JaphD/Phasetag/Bluetooth_Channel_Sounding_Tag.kicad_pcb

## KiCad design Bluetooth_Channel_Sounding_Tag.kicad_pcb (2026-10-24)

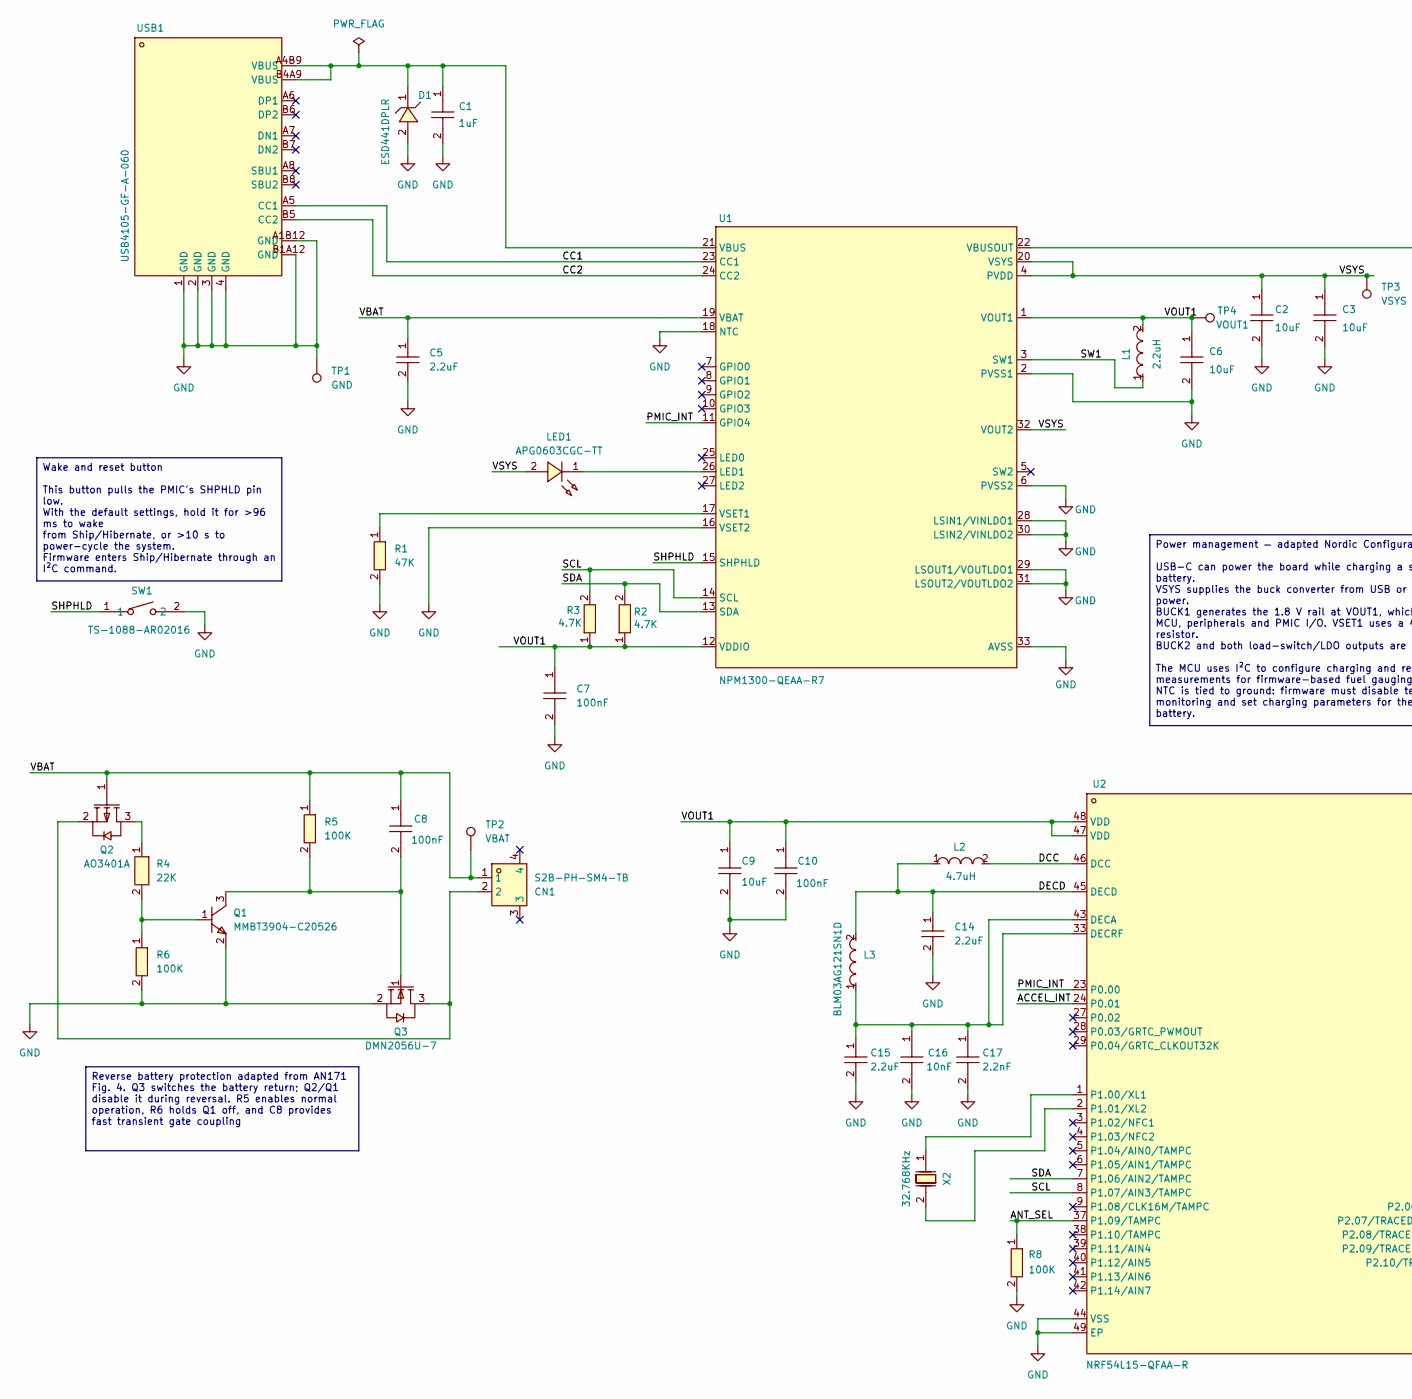
[picture p4: schematic Bluetooth_Channel_Sounding_Tag.kicad_sch, part in row 1, column 1]

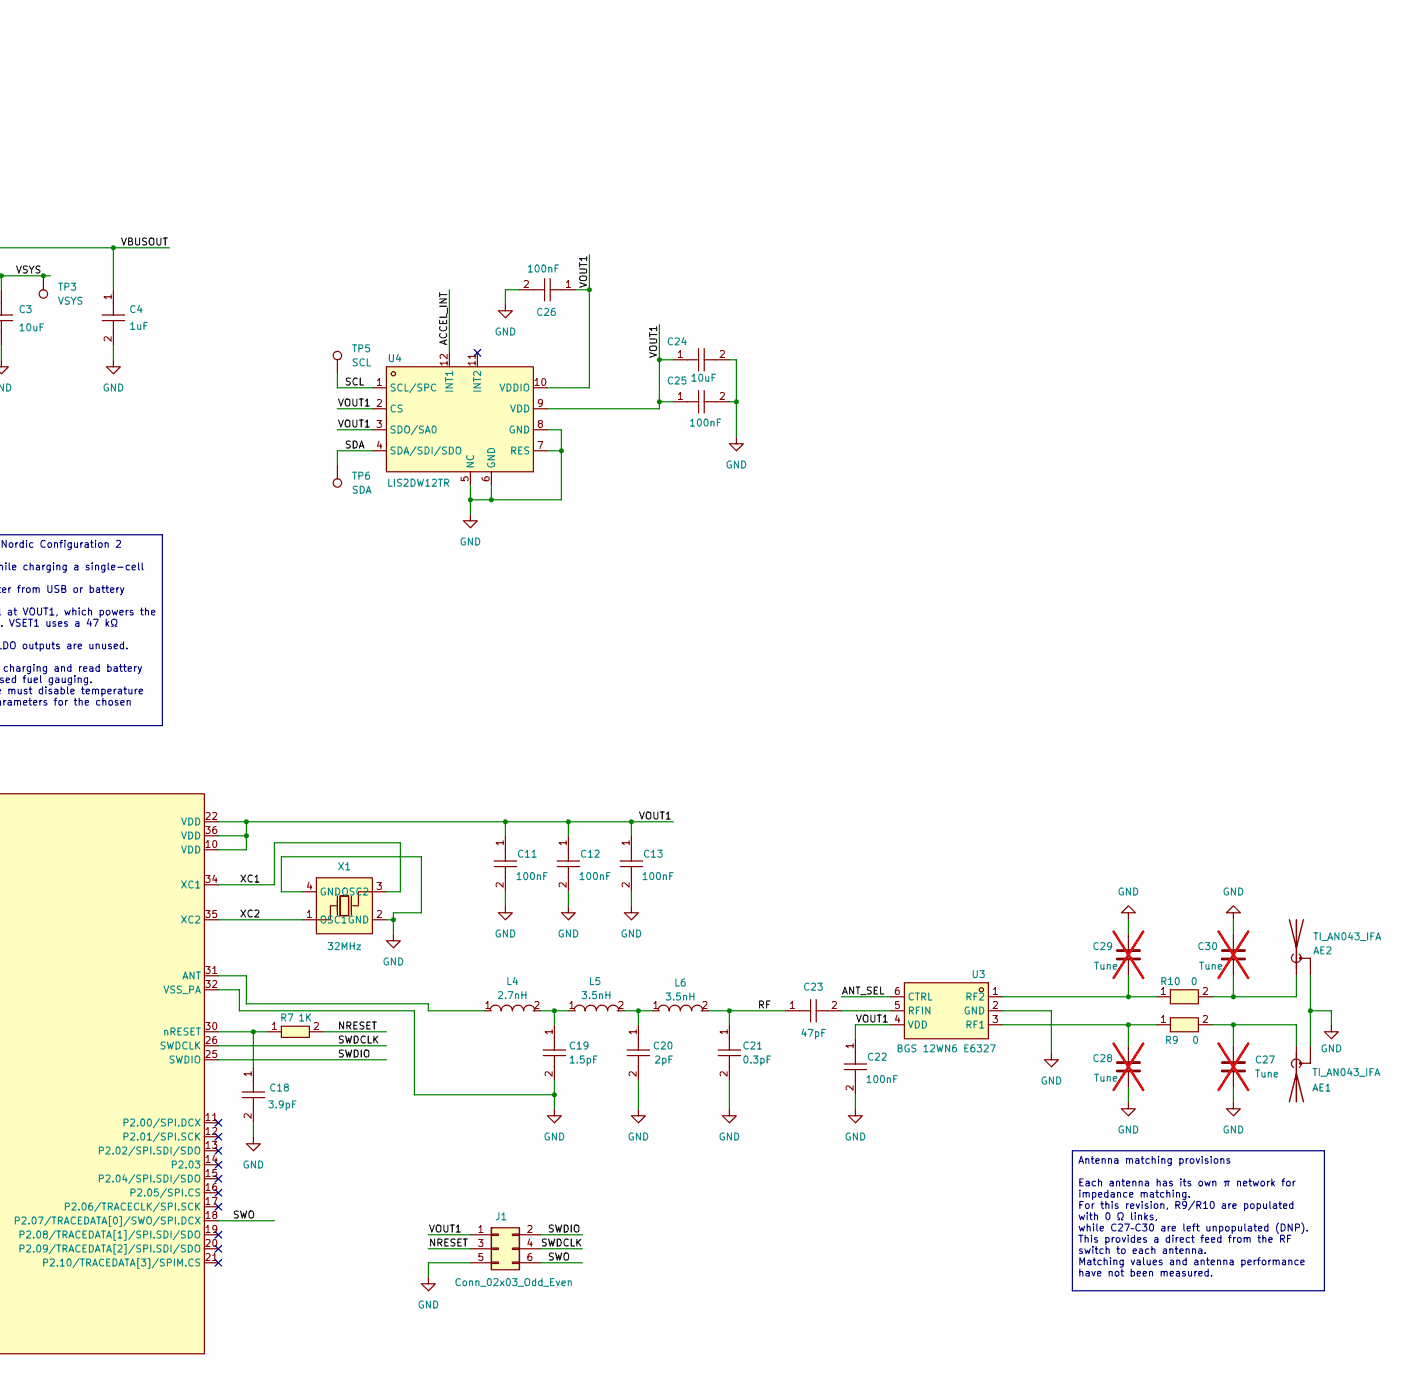
[picture p5: schematic Bluetooth_Channel_Sounding_Tag.kicad_sch, part in row 1, column 2]

Parts:
AE1: TI_AN043_IFA; Texas_SWRA117D_2.4GHz_Left
AE2: TI_AN043_IFA; Texas_SWRA117D_2.4GHz_Right
C1, C4: 1uF; C0603; MPN CL10A105KB8NNNC; LCSC Part C15849
C2, C3, C6, C24: 10uF; C0603; MPN CL10A106MA8NRNC; LCSC Part C96446
C5: 2.2uF; C0603; MPN CL10A225KO8NNNC; LCSC Part C23630
C7, C10, C11, C12, C13, C22, C25, C26: 100nF; C0201; MPN CL03A104KP3NNNC; LCSC Part C49062
C8: 100nF; C0402; MPN CL05B104KB54PNC; LCSC Part C307331
C9: 10uF; C0402; MPN GRM155R61A106ME11D; LCSC Part C408132
C14, C15: 2.2uF; C0201; MPN GRM033R60J225ME47D; LCSC Part C76933
C16: 10nF; C0201; MPN CC0201KRX7R7BB103; LCSC Part C272853
C17: 2.2nF; C0201; MPN 0201B222K160NT; LCSC Part C284975
C18: 3.9pF; C0201; MPN TCC0201COG3R9C500ZT; LCSC Part C18164580
C19: 1.5pF; C0201; MPN GJM0335C1E1R5WB01D; LCSC Part C435397
C20: 2pF; C0201; MPN GJM0335C1E2R0WB01D; LCSC Part C668326
C21: 0.3pF; C0201; MPN GJM0335C1ER30WB01D; LCSC Part C161289
C23: 47pF; C0201; MPN GRM0335C1H470JA01D; LCSC Part C85908
C27, C28, C29, C30: Tune; C0201; not fitted
CN1: S2B-PH-SM4-TB; CONN-SMD_P2.00_S2B-PH-SM4-TB-LF-SN; MPN S2B-PH-SM4-TB(LF)(SN); LCSC Part C295747
D1: ESD441DPLR; X2SON-2_L0.6-W0.3-P0.35; MPN ESD441DPLR; LCSC Part C22427765
J1: Conn_02x03_Odd_Even; Tag-Connect_TC2030-IDC-NL_2x03_P1.27mm_Vertical
L1: 2.2uH; L0805; MPN MLP2012S2R2MT0S1; LCSC Part C107322
L2: 4.7uH; L0603; MPN MLZ1608M4R7WT000; LCSC Part C76799
L3: BLM03AG121SN1D; L0201; MPN BLM03AG121SN1D; LCSC Part C97850
L4: 2.7nH; L0201; MPN LQP03HQ2N7B02D; LCSC Part C7216765
L5, L6: 3.5nH; L0201; MPN LQP03HQ3N5B02D; LCSC Part C3911055
LED1: APG0603CGC-TT; LED-SMD_L0.7-W0.4-RD_GREEN-1; MPN APG0603CGC-TT; LCSC Part C4153580
Q1: MMBT3904-C20526; SOT-23-3_L2.9-W1.3-P1.90-LS2.4-BR; MPN MMBT3904(RANGE:100-300); LCSC Part C20526
Q2: AO3401A; SOT-23_L2.9-W1.3-P1.90-LS2.4-BR; MPN AO3401A; LCSC Part C15127
Q3: DMN2056U-7; SOT-23-3_L2.9-W1.6-P1.90-LS2.8-BR; MPN DMN2056U-7; LCSC Part C332302
R1: 47K; R0201; MPN 0201WMF4702TEE; LCSC Part C270345
R2, R3: 4.7K; R0201; MPN RC0201FR-074K7L; LCSC Part C138135
R4: 22K; R0201; MPN RC0201FR-0722KL; LCSC Part C474416
R5, R6, R8: 100K; R0201; MPN RC0201FR-07100KL; LCSC Part C106224
R7: 1K; R0201; MPN 0201WMF1001TEE; LCSC Part C270365
R9, R10: 0; R0201; MPN 0201WMF0000TEE; LCSC Part C473473
SW1: TS-1088-AR02016; SW-SMD_L3.9-W3.0-P4.45; MPN TS-1088-AR02016; LCSC Part C720477
TP1: GND; TestPoint_Pad_D1.0mm
TP2: VBAT; TestPoint_Pad_D1.0mm
TP3: VSYS; TestPoint_Pad_D1.0mm
TP4: VOUT1; TestPoint_Pad_D1.0mm
TP5: SCL; TestPoint_Pad_D1.0mm
TP6: SDA; TestPoint_Pad_D1.0mm
U1: NPM1300-QEAA-R7; QFN-32_L5.0-W5.0-P0.50-TL-EP3.5; MPN nPM1300-QEAA-R7; LCSC Part C7501206
U2: NRF54L15-QFAA-R; QFN-48_L6.0-W6.0-P0.40-TL-EP4.6; MPN NRF54L15-QFAA-R; LCSC Part C42458750
U3: BGS 12WN6 E6327; TSNP-6_L1.1-W0.7-P0.40-BL; MPN BGS 12WN6 E6327; LCSC Part C534203
U4: LIS2DW12TR; LGA-12_L2.0-W2.0-P0.50-BL; MPN LIS2DW12TR; LCSC Part C189624
USB1: USB4105-GF-A-060; USB-C-SMD_GT-USB-7010E-1; MPN USB4105-GF-A-060; LCSC Part C3025063
X1: 32MHz; CRYSTAL-SMD_4P-L2.0-W1.6-BL; MPN ABM11W-32.0000MHZ-8-B1U-T3; LCSC Part C1985774
X2: 32.768KHz; CRYSTAL-SMD_L2.0-W1.2; MPN CM8V-T1A-32.768kHz-9pF-20PPM-TB-QC; LCSC Part C5280691

Connections:
/ACCEL_INT: U2.24 (P0.01), U4.12 (INT1)
/ANT_SEL: R8.1, U2.37 (P1.09/TAMPC), U3.6 (CTRL)
/CC1: U1.23 (CC1), USB1.A5 (CC1)
/CC2: U1.24 (CC2), USB1.B5 (CC2)
/DCC: L2.2, U2.46 (DCC)
/DECD: C14.1, L2.1, L3.2, U2.45 (DECD)
/NRESET: J1.3, R7.2
/PMIC_INT: U1.11 (GPIO4), U2.23 (P0.00)
/RF: C21.1, C23.1, L6.2
/SCL: R3.2, TP5.1 (1_1), U1.14 (SCL), U2.8 (P1.07/AIN3/TAMPC), U4.1 (SCL/SPC)
/SDA: R2.2, TP6.1 (1_1), U1.13 (SDA), U2.7 (P1.06/AIN2/TAMPC), U4.4 (SDA/SDI/SDO)
/SHPHLD: SW1.1, U1.15 (SHPHLD)
/SW1: L1.1, U1.3 (SW1)
/SWDCLK: J1.4, U2.26 (SWDCLK)
/SWDIO: J1.2, U2.25 (SWDIO)
/SWO: J1.6, U2.18 (P2.07/TRACEDATA[0]/SWO/SPI.DCX)
/VBAT: C5.1, C8.1, CN1.1, Q2.1, R5.1, TP2.1 (1_1), U1.19 (VBAT)
/VBUSOUT: C4.1, U1.22 (VBUSOUT)
/VOUT1: C6.1, C7.1, C9.1, C10.1, C11.1, C12.1, C13.1, C22.1, C24.1, C25.1, C26.1, J1.1, L1.2, R2.1, R3.1, TP4.1 (1_1), U1.1 (VOUT1), U1.12 (VDDIO), U2.10 (VDD), U2.22 (VDD), U2.36 (VDD), U2.47 (VDD), U2.48 (VDD), U3.4 (VDD), U4.2 (CS), U4.3 (SDO/SA0), U4.9 (VDD), U4.10 (VDDIO)
/VSYS: C2.1, C3.1, LED1.2, TP3.1 (1_1), U1.4 (PVDD), U1.20 (VSYS), U1.32 (VOUT2)
/XC1: U2.34 (XC1), X1.3 (OSC2)
/XC2: U2.35 (XC2), X1.1 (OSC1)
GND: AE1.2 (Shield), AE2.2 (Shield), C1.2, C2.2, C3.2, C4.2, C5.2, C6.2, C7.2, C9.2, C10.2, C11.2, C12.2, C13.2, C14.2, C15.2, C16.2, C17.2, C18.2, C19.2, C20.2, C21.2, C22.2, C24.2, C25.2, C26.2, C27.2, C28.2, C29.1, C30.1, D1.2, J1.5, Q1.2, Q3.2, R1.2, R6.2, R8.2, SW1.2, TP1.1 (1_1), U1.2 (PVSS1), U1.6 (PVSS2), U1.16 (VSET2), U1.18 (NTC), U1.28 (LSIN1/VINLDO1), U1.29 (LSOUT1/VOUTLDO1), U1.30 (LSIN2/VINLDO2), U1.31 (LSOUT2/VOUTLDO2), U1.33 (AVSS), U2.32 (VSS_PA), U2.44 (VSS), U2.49 (EP), U3.2 (GND), U4.5 (NC), U4.6 (GND), U4.7 (RES), U4.8 (GND), USB1.1 (GND), USB1.2 (GND), USB1.3 (GND), USB1.4 (GND), USB1.A1B12 (GND), USB1.B1A12 (GND), X1.2 (GND), X1.4 (GND)
unnamed: AE1.1 (A), C27.1, R9.2
unnamed: AE2.1 (A), C30.2, R10.2
unnamed: C8.2, Q1.3, Q3.1, R5.2
unnamed: C19.1, L4.2, L5.1
unnamed: C20.1, L5.2, L6.1
unnamed: CN1.2, Q2.2, Q3.3
unnamed: Q1.1, R4.2, R6.1
unnamed: Q2.3, R4.1
unnamed: LED1.1, U1.26 (LED1)
unnamed: C1.1, D1.1, U1.21 (VBUS), USB1.A4B9 (VBUS), USB1.B4A9 (VBUS)
unnamed: R1.1, U1.17 (VSET1)
unnamed: L4.1, U2.31 (ANT)
unnamed: C15.1, C16.1, C17.1, L3.1, U2.33 (DECRF), U2.43 (DECA)
unnamed: U2.1 (P1.00/XL1), X2.1
unnamed: U2.2 (P1.01/XL2), X2.2
unnamed: C18.1, R7.1, U2.30 (nRESET)
unnamed: C28.1, R9.1, U3.3 (RF1)
unnamed: C29.2, R10.1, U3.1 (RF2)
unnamed: C23.2, U3.5 (RFIN)

Notes on the sheet:
Reverse battery protection adapted from AN171 Fig. 4. Q3 switches the battery return; Q2/Q1 disable it during reversal. R5 enables normal operation, R6 holds Q1 off, and C8 provides fast transient gate coupling
Power management — adapted Nordic Configuration 2 USB-C can power the board while charging a single-cell battery. VSYS supplies the buck converter from USB or battery power. BUCK1 generates the 1.8 V rail at VOUT1, which powers the MCU, peripherals and PMIC I/O. VSET1 uses a 47 kΩ resistor. BUCK2 a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
Antenna matching provisions Each antenna has its own π network for impedance matching. For this revision, R9/R10 are populated with 0 Ω links, while C27–C30 are left unpopulated (DNP). This provides a direct feed from the RF switch to each antenna. Matching values and antenna performance have not b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
Wake and reset button This button pulls the PMIC's SHPHLD pin low. With the default settings, hold it for >96 ms to wake from Ship/Hibernate, or >10 s to power-cycle the system. Firmware enters Ship/Hibernate through an I²C command.

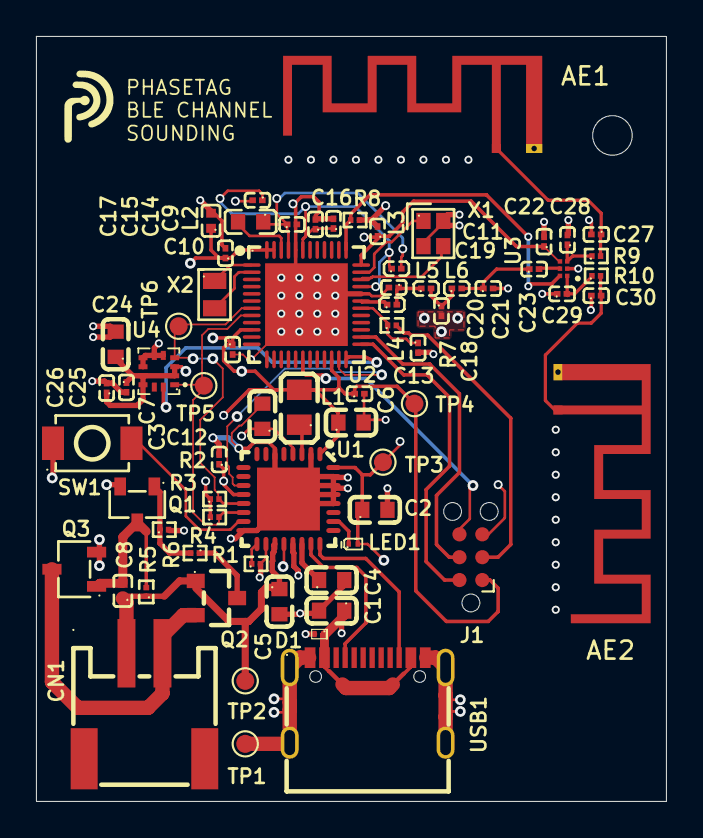
[picture p6: board Bluetooth_Channel_Sounding_Tag.kicad_pcb from above]

Board: 4 copper layers, 35.0 x 42.5 mm, 70 parts (0 on the bottom side), 42 nets.

Other parts of the board:
H1: MountingHole_2.2mm_M2
