JaphD/Phasetag/(commit log)

2026-09-30 Add initial KiCad project and power circuitry
    Include the current schematic, PCB placeholder, and custom component libraries. Ignore local references, working notes, and generated KiCad files.
2026-10-01 Add MCU, radio and motion sensor circuitry
    Add the nRF54L15 supply filtering and decoupling, 32 MHz and 32.768 kHz crystals, reset circuit, and Tag-Connect SWD/SWO programming interface.
    Wire the radio matching network and BGS12WN6 antenna switch, including its control pull-down and RF input DC-blocking capacitor. Add the LIS2DW12 accelerometer, its decoupling, shared I2C connection, and motion interrupt. Connect the nPM1300 interrupt to the MCU and add ESD441 protection to USB VBUS.
    Mark all 23 unused MCU pins as intentionally unconnected, including the UART pins now that serial test pads have been dropped. Include the imported component symbols, footprints, and 3D models, and update the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
2026-10-10 Add antenna matching and prepare the PCB for layout
    Add two PCB antenna symbols with separate matching networks and six test
    points for power rails and I2C. Add schematic notes explaining the PMIC
    configuration, wake button and unpopulated antenna matching components.
    Correct the USB-C mounting slots and locating holes, RF switch pads and
    courtyard, and SMD attributes on the 0201 passives and low-frequency
    crystal. Register the custom footprints in the project-local BCS library
    and update their schematic assignments.
    Configure the four-layer JLCPCB stack-up, fabrication clearances, track
    and via presets, and a component hole-spacing rule. Transfer 67 footprints
    and their nets into the PCB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
2026-10-20 Place components and start routing the PCB
    Expand the board to 35 x 42.5 mm with 2 mm rounded corners. Add the M2
    mounting hole and two antenna reservations, and arrange the power, MCU,
    sensor, RF and programming components.
    Add initial routing for the USB input, battery protection, PMIC power
    connections, I2C, button, testpoints and 32 kHz crystal. Reposition L1 and
    C6 to shorten the BUCK1 switch connection and improve the output routing.
    Include the updated project settings and repositioned schematic drawing.
    This is an in-progress layout checkpoint. Ground planes and returns,
    remaining supply and bus connections, debug, the 32 MHz crystal and RF
    and antenna routing still need work. ERC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
2026-10-23 Route the RF paths and add PhaseTag branding
    Add ground pours and RF grounding, route both PCB antennas through the RF switch, and define the 50-ohm RF routing profile.
    Refine power, signal and debugger routing, assign the antenna footprints in the schematic, and add the PhaseTag logo, product name, designer credit and revision marking.
2026-10-24 Refine board annotations and organize logo assets
    Add 35 x 42.5 mm board dimensions on the drawing layer and adjust the crystal placement and component reference labels. Rename Branding to logo and retain the current project settings.
2026-10-26 Add project overview and board images
    Explain PhaseTag's hardware, design choices, manufacturing approach and validation status in the README. Include the top and bottom renders and PCB layout image, and allow the README through the Markdown ignore rule.
